jyjblrd/Core-R-Theta-4-Axis-Printer/(threads)

Thread 3 (2024-12-05):

Add docs for build

TimTheBig, 2024-12-05:
I'm interested in a build to add support to my own slicer however the lack of instructions is a big turn off

xobes, 2024-12-08:
What is is you're looking for?  A step-by-step for the physical build? Or software "build" instructions?

TimTheBig, 2024-12-08:
The physical build would be great.

greywolf4002, 2024-12-10:
Yeah I agree, I might start this project sometime at the end of January so if nothing is updated I'll make a list on my own.

jyjblrd, 2024-12-23:
Hi, unfortunately I don't have the time to make a build guide but please feel free to make one and upload it as a PR, it would really help the community

xobes, 2025-01-05:
I will be doing this in the coming weeks, am doing a build presently and taking lots of pics

xobes, 2025-01-09:
I have a lot of pictures, but I've also discovered I was missing some parts, so while I wait for those, I've made some modifications to several b-axis parts and so my "build instructions" and screw counts aren't going to be 100% aligned with the original -- partly due to the fact that I bought button-head screws instead of both flat-head and socket-cap screws.

I'll be starting the documentation in my fork, and will not deviations accordingly.  I do think that these things will improve as more people go through the motions such that more optimizations can be made as things progress.

pele1659, 2025-03-30:
hello i can't find an 3D model for bilding the printer.
the only model i fond is https://mycam641.autodesk360.com/g/shares/SH30dd5QT870c25f12fcf82c385dbe23a74f that.
where can i find the model for the bilding?

jyjblrd, 2025-03-31:
it should be called "extruder mount"

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

pele1659, 2025-04-01:
Thank you for the reply.
I downloaded again the zip file with all the files, but I still see only one part.
I tray to open it in another computer and get the same result.

oldnslow, 2025-04-01:
@pele1659
> I downloaded again the zip file with all the files, but I still see only one part.

Please forgive me if i misunderstand your issue, but just to clarify:
Are you looking for the .stl files required to print the parts or are you looking for instructions on how to assemble the printer?

If you are looking for the .stl files you should find them on the git site here:
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

After you **_extract_** the files from the .zip folder you should find the .stl files here:

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

oldnslow, 2025-04-01:
Ah, very good, you are a little ways ahead of me!  My understanding is that there are no detailed assembly instructions at this time - one of us Core-R-Theta enthusiasts will have to fill that breach!

You can  however take a look at the printer components as an assembly to see what goes where via the 4 axis polar 3d printer.step file which i was able to open in [FreeCad](https://www.freecad.org/).
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

or via the 4 axis polar 3d printer.f3z file which, **_if you first rename it to .zip and then extract the files_** (should find four .f3d files),
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

you can then open with the the [Autodesk Viewer](https://viewer.autodesk.com/designviews) (requires an account and a little patience, i had to move the extracted files out of the original .zip directory to get it to work).
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

Thread 4 (2024-12-08):

BOM Details are incomplete.

xobes, 2024-12-08:
Some of your links to parts are being redirected and the description isn't complete. e.g. "Control Board" link:

https://www.aliexpress.us/item/1005002372751834.html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

Now redirects to https://www.aliexpress.us/item/3256802186437082.html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

What control board is really needed?

xobes, 2024-12-08:
Honestly it seems like all the aliexpress links redirect... It's discomforting to not have full descriptions in the BOM.

ehegenberger, 2024-12-08:
Agreed. For example, I'm guessing T-nuts should be M4 after checking various holes in Fusion, but it's a bit of a puzzle. Really looking forward to piecing it all together though!

xobes, 2024-12-08:
Well, that's exactly to the point right there, I think I selected M3... I'll have to take a closer look.

jyjblrd, 2024-12-23:
Hey guys sorry about that, the BOM is admittedly not great but please feel free to update it if you have the time. The board I used is the Mellow Gloomy FLY RRF E3 PRO V3.0

Anarchiste-mouton, 2025-04-22:
@oldnslow thank you very much ! Indeed that motivates me to also jump in this project.
I see JLCCNC request minimum 5 item for PCB plate, does someone has an extra one to re-sell in Europe ?

oldnslow, 2025-04-24:
@Anarchiste-mouton good luck with your build! - my parts are just starting to arrive.  Feedback on the accuracy of the BOM would be appreciated.

Note that the Fly E3 Pro v3 is no longer available -(watch out for **non** Mellow 3D scam sites on Aliexpress) but [Mellow 3D](https://mellow.aliexpress.com/store/1531088) now has a replacement - the  [FLY E3 PRO Ultra](https://vi.aliexpress.com/item/1005008869172479.html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)

TheOnlyMann, 2025-05-19:
@oldnslow now that the semester is over I am again interested within my grasp to bring this project in my terms. thanks for the assist. I'm still miles away from ordering one but ill have it one way or another

oldnslow, 2025-05-22:
@TheOnlyMann good to hear you have a little time now for the project, good luck and be tenacious!

My purchased components have all arrived but first have to get my current printer up and running in order to make parts for the Core-R-&theta; so another month or two.

EmmanuelMess, 2025-08-05:
> [@EmmanuelMess](https://github.com/EmmanuelMess) Good catch, presume you are referring to the images associated with the linear guides. I think i choose those to highlight the differences between C and H carriages for those who are unaware of the two sizes. The quantities listed are correct, will add a note to clarify.

This set is extra, the other guides already arrive with carriages:

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

Thread 6 (2024-12-09):

GT2 Belt Loop 760mm or 752mm?

xobes, 2024-12-09:
GT2 Belt Loop 760mm

Looks like a 752mm loop was used and the tensioner is half-way -- would 750 be too big and cause tensioning to the limit?

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

jyjblrd, 2024-12-23:
You can always edit the 3d files to make the belt tensioner longer, but both lengths should be alright

Chuckles182, 2025-01-06:
I just uploaded a remixed Ender 3 belt tensioner to be able to use a 760 mm belt.
https://www.printables.com/model/1137828-4-axis-x-axis-tensioner
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

TheOnlyMann, 2025-01-08:
that's awesome, though the original design seems to use 2 more idlers to match the belt width- so i wonder how did oyu get around it.
you also seem to have changed up some of the mounting design to get aroudn the original design, which also would nice to be shared/commented upon!

jyjblrd, 2025-01-08:
Yeah @Chuckles182 your build looks interesting, could you share more details / pictures about it?

Chuckles182, 2025-01-08:
Where would be the best place to upload more info on my changes? I’m not very familiar with how GitHub works.

jyjblrd, 2025-01-08:
maybe make a discussion post, you should be able to add images and files

Thread 10 (2025-01-03):

Cooling jet stl?

ehegenberger, 2025-01-03:
Could you please include the stl for your cooling air jet nozzles? And what is that white (tape?) just where the air hose connects to the shroud?

ehegenberger, 2025-01-03:
Thanks! Any reason you printed this in two parts, besides the potential awkward orientation on the build plate?

jyjblrd, 2025-01-04:
yeah its just for printability

Closed 2025-01-03.

Thread 14 (2025-01-05):

Consider adding which region or axis each given part is for within the BOM (e.g. a column titled "Axis")

xobes, 2025-01-05:
Consider adding which region or axis each given part is for within the BOM (e.g. a column titled "Axis")

TheOnlyMann, 2025-01-06:
I agree with this to divide the stl parts by regions used
as well as a checklist markdown file to make it easy for people to build it
if not former(its harder to download/load) least the latter should be acknowledged

Thread 15 (2025-01-05):

Consider adding pictures of the parts in the BOM for clarity.

xobes, 2025-01-05:
Consider adding pictures of the parts in the BOM for clarity.

TheOnlyMann, 2025-01-06:
Possibly someone needs to have a detailed assembly guide image somewhere, i agree

Thread 17 (2025-01-06):

FLY board requires 2 pin jumper pins

TheOnlyMann, 2025-01-06:
[https://teamgloomy.github.io/fly_e3_pro_v3_general.html](https://teamgloomy.github.io/fly_e3_pro_v3_general.html)
according to this, since we are only using 1 z motor, we need a jumper pin installed on the other z.
same goes for the diag pins as we utilize sensorless homing for the most part

Chuckles182, 2025-01-06:
What would the correct wiring be? There are four stepper motors, is one of them driven from E0 or E1?
C axis = ?
Z axis = Z1
X and B axis motors = ?

jyjblrd, 2025-01-06:
@Chuckles182 its arbitrary, and set in the config. Eg:
```
M584 C0 Z4 X1 B2 E3 S0
```

C is drive 0, Z is 4, etc.

TheOnlyMann, 2025-01-08:
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

one thing to check, did you install the jumper pins? if you did i wonder what sizes they are, the wiki doesnt seem to state and there seems to be 2 types, 2.54mm and 2.00mm

xobes, 2025-01-09:
My board came with 5 jumpers -- 2.54 (0.1 in) jumpers.  I happen to have a treasure trove of these in my electronics parts, too.

Thread 39 (2025-04-24):

F360/.step files missing components compared to the F360 online shared link

Bolado, 2025-04-24:
Hey!

I was checking out the uploaded F360/STEP files and comparing them to the ones in [this shared link](https://mycam641.autodesk360.com/g/shares/SH30dd5QT870c25f12fcf82c385dbe23a74f), and it looks like there are a few differences. Some parts are missing in one but present in the other — for example:
- The X-axis belts are in the shared link but not in the uploaded files.
- The electronics box is in the uploaded files but not in the shared version.

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

Having the latest F360/STEP files would be super helpful so we can start tweaking and improving things. An up-to-date model would also mean we can rely less on the build guide when getting started.

Still — this is an awesome project! Great work so far! 🙌

Bolado, 2025-05-06:
I've used the latest uploaded one to start working on my own with the real parts instead of the blocks [in here](https://cad.onshape.com/documents/145a561fa0708031fc59dce6/w/331db64840b847b58d217cbb/e/5fef6e10718c7e4dbfe557d5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), much appreciated.

Closed 2025-05-06.

Thread 44 (2025-05-05):

More pictures?

sarahlegeza, 2025-05-05:
For an easy up on the ability to actually build this, could you just take some more pictures of the assembled printer? I've been looking between the YouTube video and the STEP files, but just having some pictures of it would help assembly greatly.

I'm thinking a wide shot directly from the X, Y, and Z axis' of the printer, then some close ups of the belts and their setups. Any additional pictures would be extremely instructional.

Bolado, 2025-05-06:
Till someone writes a build guide with pictures/drawings, the best way is to go through the CAD.

I have been working on the CAD, with proper real parts instead of blocks, and some improvements, but you can make a copy and just look how things goes together.

[You can have a look here](https://cad.onshape.com/documents/145a561fa0708031fc59dce6/w/331db64840b847b58d217cbb/e/5fef6e10718c7e4dbfe557d5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)

Hide some parts, and then start showing them while you build.

dagrende, 2025-05-06:
Excellent! Much easier to understand the design with this beautiful coloring1

jyjblrd, 2025-05-06:
Looks good @Bolado!

sarahlegeza, 2025-05-07:
Ah that CAD is very helpful! Thanks @Bolado

Closed 2025-05-07.

Thread 56 (2025-08-05):

Aliexpress links broken

xTremePower, 2025-08-05:
Hello, I'm in Europe, but all your Aliexpress links are not the same style and many of them are .us

I can't find the most important ones like the control board and other special parts, and because you just write Control board in the list, I can't even search manually :(

Can you give proper links please or at least write on text the reference of the parts ?

Thanks you a lot

Thread 57 (2025-08-14):

Part questions

PixelatedTsunami, 2025-08-14:
I was quite confused when looking at the part list, specifically for what a collet is for. That and I think there are some parts missing, including a timing pully that drives the rotational axis. I have also acquired everything else for the printer and am super excited to put this thing together when my library is done printing the frame, and my fly board comes in; thanks for open sourcing the project!

PixelatedTsunami, 2025-08-14:
Side note, I have no experience with soldering and was wondering how you would recommend going about the heated bed? I have already had JLPCB print it, but I don't know where I should start with getting electrical components sourced/assembled.

oldnslow, 2025-08-14:
You may find it helpful to take a look at the [more complete parts list found in Issue #4](https://github.com/jyjblrd/Core-R-Theta-4-Axis-Printer/issues/4#issuecomment-2790560877).  The "collet" listed on the main repository  page is more commonly referred to as a Shaft Collar or Retaining Ring (3rd from bottom of proposed BOM in issue #4) and is used to secure the extruder mount to the B axis shaft - see red component below.

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

Although not specific to your sourcing/assembling question, a search for "Heated Bed" in the Issues and Discussions sections of the repository may be a useful exercise to see what others have done.

Good luck with your build!
