jyjblrd/Core-R-Theta-4-Axis-Printer/(commit log)

2025-04-26 better config files for homing and new extruder mount
    [config.g, homeall.g, homeb.g, homex.g, to4axis.g, topolar.g]
2025-06-08 default to 4 axis mode in config to avoid confusion
    https://github.com/jyjblrd/S4_Slicer/issues/15
    [config.g]
